stevemarple/PoE_magnetometer/hardware/enclosure/original_prototype/poe_box.dxf

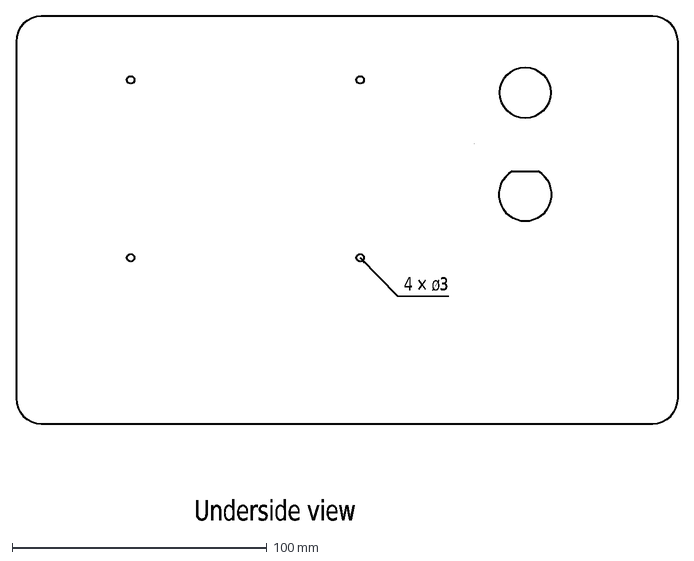
[picture p1: CAD file, 2016-11-02]
hardware/enclosure/original_prototype/poe_box.dxf
4 × ø3
Underside view
