stevemarple/PoE_magnetometer/hardware/enclosure/v1.0.0/drilling.dxf

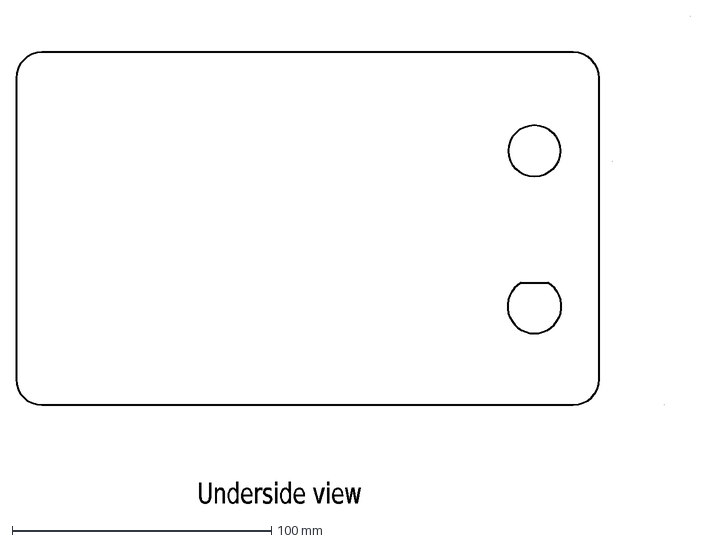
[picture p2: CAD file, 2016-02-08]
hardware/enclosure/v1.0.0/drilling.dxf
Underside view
