stevemarple/PoE_magnetometer/hardware/enclosure/original_prototype/poe_plastic_box.dxf

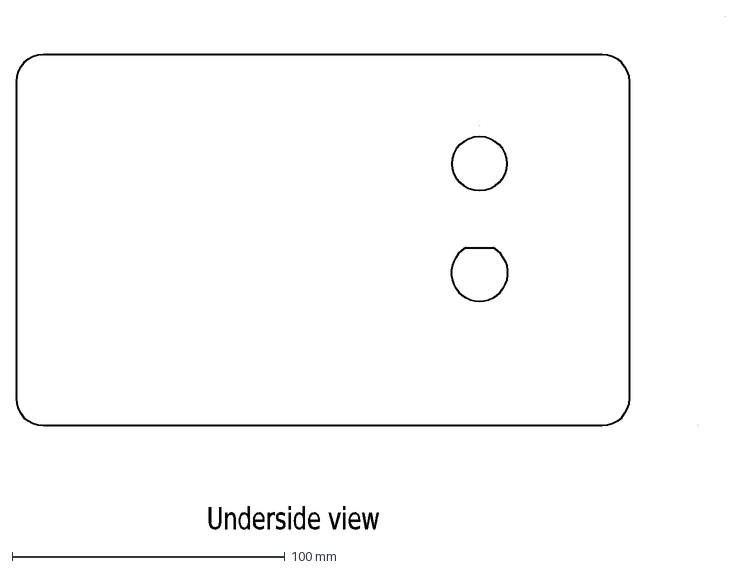
[picture p3: CAD file, 2016-11-02]
hardware/enclosure/original_prototype/poe_plastic_box.dxf
Underside view
