stevemarple/PoE_magnetometer/hardware/enclosure/original_prototype/poe_plastic_box_insert.dxf

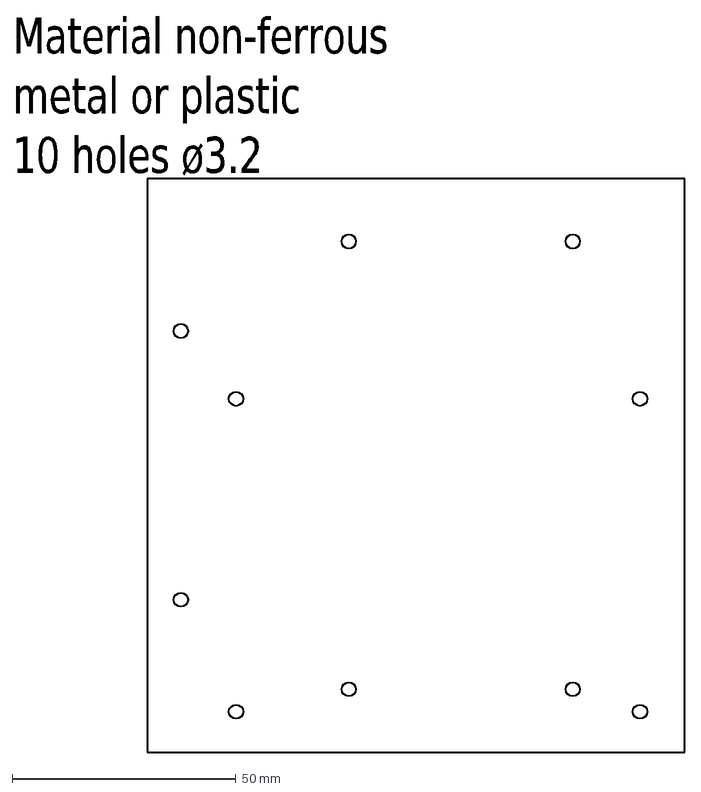
[picture p4: CAD file, 2016-11-02]
hardware/enclosure/original_prototype/poe_plastic_box_insert.dxf
Material non-ferrous metal or plastic 10 holes ø3.2
