stevemarple/PoE_magnetometer/(commit log)

2015-10-15 Add hardware files
    [Calunium_v2_smd_1.brd, Calunium_v2_smd_1.sch, PoE_mag_main.brd, PoE_mag_main.sch, W5500_shield.brd, W5500_shield.sch]
2015-10-16 Misc changes
    [Calunium_v2_smd_1.sch, Calunium_v2_smd_2.brd, Calunium_v2_smd_2.sch, PoE_mag_main.brd, PoE_mag_main.sch]
2015-10-19 Add new board versions
    [Calunium_v2_smd_2.sch, NV08C_GPS_shield.brd, NV08C_GPS_shield.sch, NV08C_GPS_shield_v1.1_reduced.brd, NV08C_GPS_shield_v1.1_reduced.sch, PoE_mag_main_alt.brd, PoE_mag_main_alt.sch]
2015-10-19 Add level shifting circuit
    [FLC100_level_shifting.brd, FLC100_level_shifting.sch, FLC100_shield_v2.1.brd, FLC100_shield_v2.1.sch]
2015-10-20 Layout fixes
    [FLC100_level_shifting.brd, FLC100_level_shifting.sch, NV08C_GPS_shield_v1.1_reduced.brd, NV08C_GPS_shield_v1.1_reduced.sch, PoE_mag_main_alt.brd, PoE_mag_main_alt.sch]
2015-10-20 Add magnetometer level shifting
    [PoE_mag_main_alt.brd, PoE_mag_main_alt.sch]
2015-10-21 Add schematics and boards for various modules
    [Calunium_v2_smd_2.brd, Calunium_v2_smd_2.sch, FLC100_level_shifting_cloud.brd, FLC100_level_shifting_cloud.sch, FLC100_level_shifting_mag.brd, FLC100_level_shifting_mag.sch, PoE_mag_main_alt.brd, PoE_mag_main_alt.sch]
2015-10-29 Add Fibox box outline
    [PoE_mag_main_alt.brd, PoE_mag_main_alt.sch]
2015-10-29 Update W5500 shield
    [W5500_shield.brd, W5500_shield.sch]
2015-11-06 Update enclosure outline, move components
    [PoE_mag_main_alt.brd, PoE_mag_main_alt.sch]
2015-11-09 Add updated hardware version
    [PoE_mag_main_alt2.brd, PoE_mag_main_alt2.sch]
2015-11-09 Update enclosure outline
    [PoE_mag_main_alt2.brd, PoE_mag_main_alt2.sch]
2015-11-09 Update enclosure restrictions
    [PoE_mag_main_alt2.brd, PoE_mag_main_alt2.sch]
2015-11-10 Fix silkscreen text
    [PoE_mag_main_alt2.brd, PoE_mag_main_alt2.sch]
2015-11-11 Use TO220 package of LD1117
    [PoE_mag_main_alt2.brd, PoE_mag_main_alt2.sch]
2015-11-11 Board layout changes
    [PoE_mag_main_alt2.brd, PoE_mag_main_alt2.sch]
2015-11-12 Add Powerpax reg option, move RJ11/45 connectors
    [PoE_mag_main_alt3.brd, PoE_mag_main_alt3.sch]
2015-11-13 Minor changes
    [PoE_mag_main_alt3.brd]
2015-11-13 Rotate RJ11, RJ45 by 180 degrees
    [PoE_mag_main_alt4.brd, PoE_mag_main_alt4.sch]
2015-11-16 Version before routing, and possible final routing
    [PoE_mag.brd, PoE_mag.sch, PoE_mag_pre-routing.brd, PoE_mag_pre-routing.sch]
2015-11-17 Improve layout and track spacing
    [PoE_mag.brd]
2015-11-17 Fix incorrect USB power filtering
    [PoE_mag.brd, PoE_mag.sch]
2015-11-17 Routed layout with no DRC warnings
    [PoE_mag.brd, PoE_mag.sch]
2015-11-18 Minor changes for ground pour
    [PoE_mag.brd, PoE_mag.sch]
2015-11-18 Add Gerber files
    [PoE_mag.GBL, PoE_mag.GBO, PoE_mag.GBP, PoE_mag.GBS, PoE_mag.GTL, PoE_mag.GTO, PoE_mag.GTP, PoE_mag.GTS]
2015-11-18 Remove intermediate alternative versions
    [PoE_mag_main_alt.brd, PoE_mag_main_alt.sch, PoE_mag_pre-routing.brd, PoE_mag_pre-routing.sch]
2015-11-18 Always power LM61 and swap to SOT23 package
    [PoE_mag.brd, PoE_mag.sch]
2015-11-18 Update Gerber files
    [PoE_mag.GBL, PoE_mag.GBS, PoE_mag.GTL, PoE_mag.GTO, PoE_mag.GTP, PoE_mag.GTS]
2015-11-18 Improve decoupling for voltage regulators
    [PoE_mag.brd, PoE_mag.sch]
2015-11-19 Renumber components
    [PoE_mag.brd, PoE_mag.sch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]
2015-11-19 Move battery holder
    Move to create more room so that alternative versions can be used.
    [PoE_mag.brd, PoE_mag.sch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]
2016-01-14 Update crystal value
    [PoE_mag.brd, PoE_mag.sch]
2016-01-14 Increase diameter of mounting holes
2016-01-14 Increase dia of mounting holes, increase thermal reliefs
    [PoE_mag.brd, PoE_mag.sch]
2016-01-14 Add pads for support wire over 32768Hz crystal
    [PoE_mag.brd, PoE_mag.sch]
2016-01-22 Increare mounting holes to 4mm diameter
2016-01-22 Reroute bottom layer tracks to avoid lugs on box
    Also use 4mm diameter mounting holes
    [PoE_mag.brd, PoE_mag.sch]
2016-01-29 Add cap for RFI suppression across fan, minor track layout changes
    [PoE_mag.brd, PoE_mag.sch]
2016-01-31 Increase pad size for CR2032 battery holder
    [PoE_mag.brd, PoE_mag.sch]
2016-02-07 Show alternative build configurations more clearly
    Move TO-220 variant of LD1117V33 to show it is the alternative
    fit. Use short dashed lines to connect all optional/variant
    components. Add "*" suffix to component values which are
    optional/variants to ease construction o the standard version. Minor
    silkscreen changes on board to accomodate longer text.
    [PoE_mag.brd, PoE_mag.sch]
2016-02-08 Add decoupling for supply voltage measurement
    [PoE_mag.brd, PoE_mag.sch]
2016-02-08 Moving design files into specific v1.1 directory
    [Calunium_v2_smd_1.sch, Calunium_v2_smd_2.brd, Calunium_v2_smd_2.sch, FLC100_level_shifting.brd, FLC100_level_shifting.sch, FLC100_level_shifting_cloud.brd, FLC100_level_shifting_cloud.sch, FLC100_level_shifting_mag.brd]
2016-02-08 Add version 1.0 files from commit ca8d9ab29a9d674b81ec7ae46e74108e80dcdbfc
    [PoE_mag.GBL, PoE_mag.GBO, PoE_mag.GBP, PoE_mag.GBS, PoE_mag.GTL, PoE_mag.GTO, PoE_mag.GTP, PoE_mag.GTS]
2016-02-08 Remove unwanted file
    [Calunium_v2_smd_1.brd]
2016-02-08 Use semantic versioning for hardware
    Latest revision termed v1.0.1, reflecting that it has mainly cosmetic
    changes. Only electrical change is addition of decoupling capacitor
    for ADC measurement of supply voltage.
    [PoE_mag.GBL, PoE_mag.GBO, PoE_mag.GBP, PoE_mag.GBS, PoE_mag.GTL, PoE_mag.GTO, PoE_mag.GTP, PoE_mag.GTS]
2016-02-08 Add drilling details for Fibox plastic box
    [drilling.dxf]
2016-02-08 Fix incorrect version number on schematic
    [PoE_mag.sch]
2016-02-08 Use semantic versioning on PCB
    [PoE_mag.brd]
2016-02-08 Add v1.0.1 Gerber files
    [PoE_mag.GBL, PoE_mag.GBO, PoE_mag.GBP, PoE_mag.GBS, PoE_mag.GTL, PoE_mag.GTO, PoE_mag.GTP, PoE_mag.GTS]
2016-02-08 Changed ignored Gerber files
2016-11-02 Renamed with version number
    [drilling.dxf]
2016-11-02 Add drawings used for enclosure with original prototype
    [poe_box.dxf, poe_plastic_box.dxf, poe_plastic_box_insert.dxf]
